Danjovic/AVeRCADE/README.md

# AVeRCADE
Customisable USB adapter for arcade controls.

AVeRCADE is a flexible USB adapter for arcade controls based on AVR and V-USB. It can also work as a generic development board, since it uses USBaspLoader to update the firmware.
