Danjovic/AVeRCADE/Doc/AVerCADE-Digital-connect.png

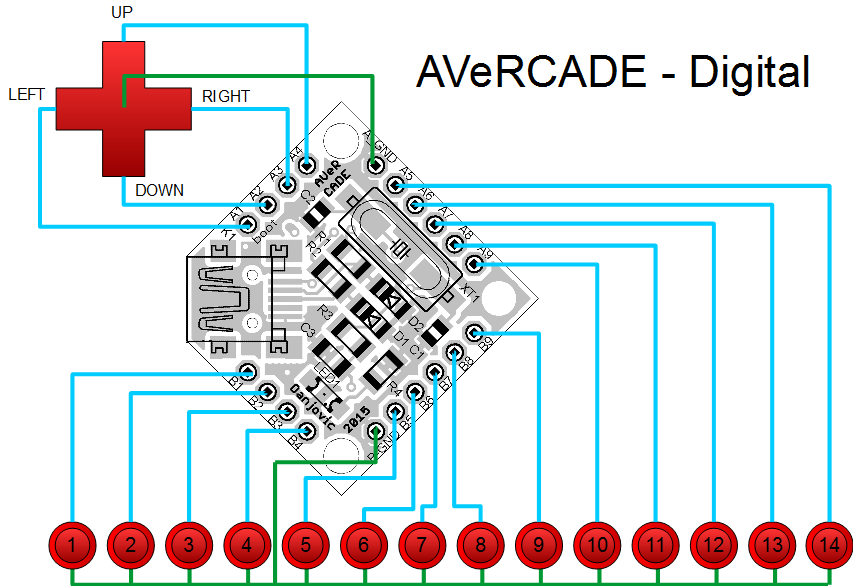
Doc/AVerCADE-Digital-connect.png
