Danjovic/AVeRCADE/Doc/AVerCADE-Dual Analog-connect.png

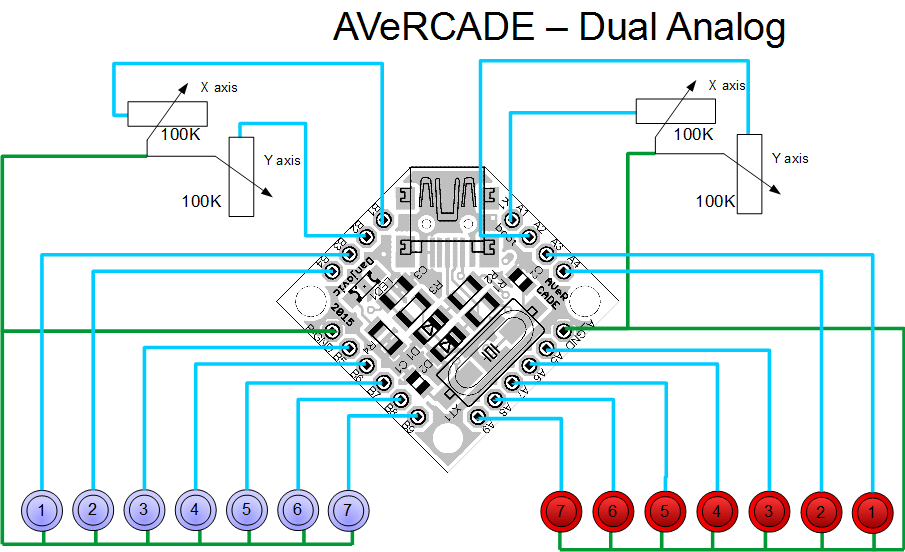
Doc/AVerCADE-Dual Analog-connect.png
