Danjovic/AVeRCADE/Doc/AVerCADE-Dual Digital-connect.png

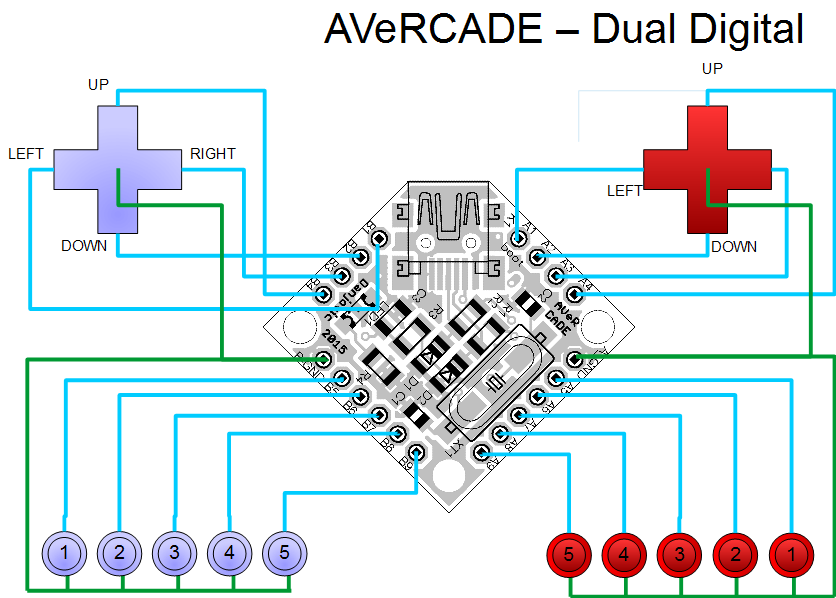
Doc/AVerCADE-Dual Digital-connect.png
