Danjovic/AVeRCADE/Doc/AVeRCADE-Dual Genesis.png

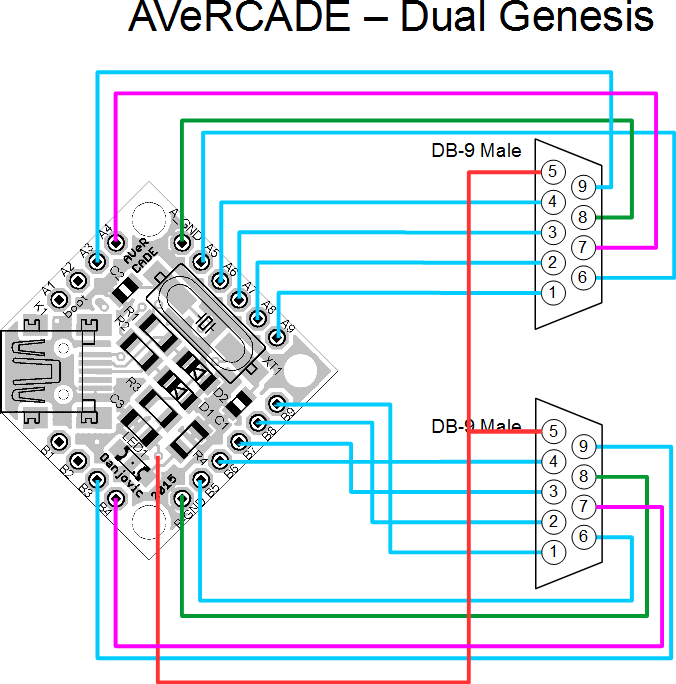
Doc/AVeRCADE-Dual Genesis.png
