Danjovic/AVeRCADE/Doc/AVerCADE-DualAtari-connect.png

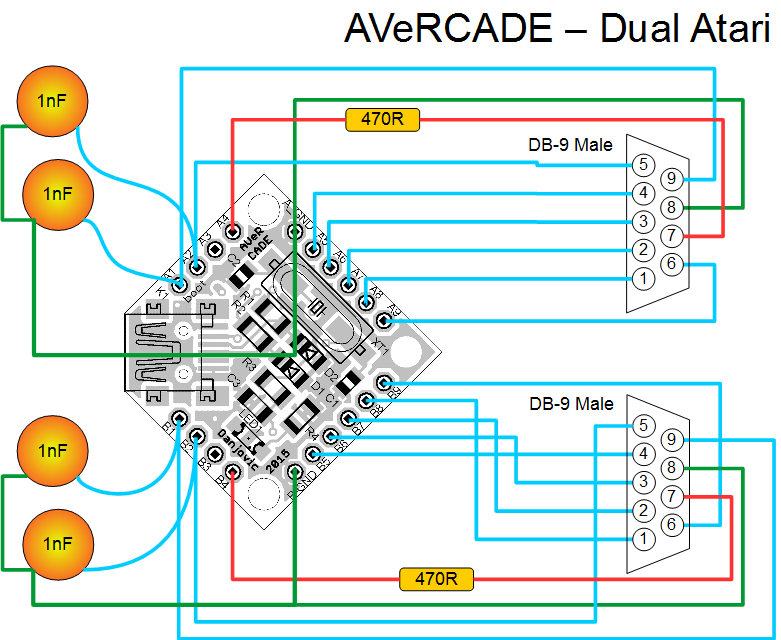
Doc/AVerCADE-DualAtari-connect.png
