Danjovic/AVeRCADE/Doc/AVerCADE-SixAxis-connect.png

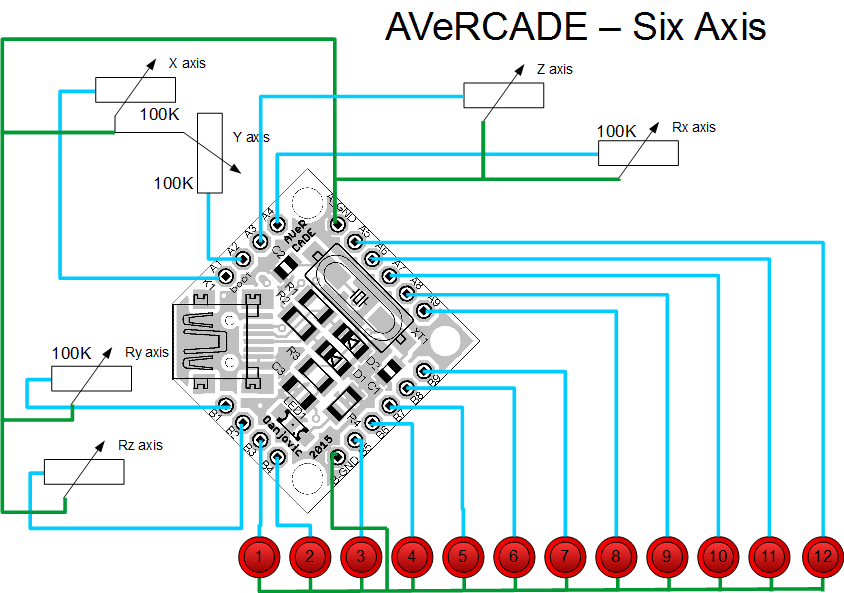
Doc/AVerCADE-SixAxis-connect.png
