Danjovic/AVeRCADE/Doc/AVerCADE-USBasp.png

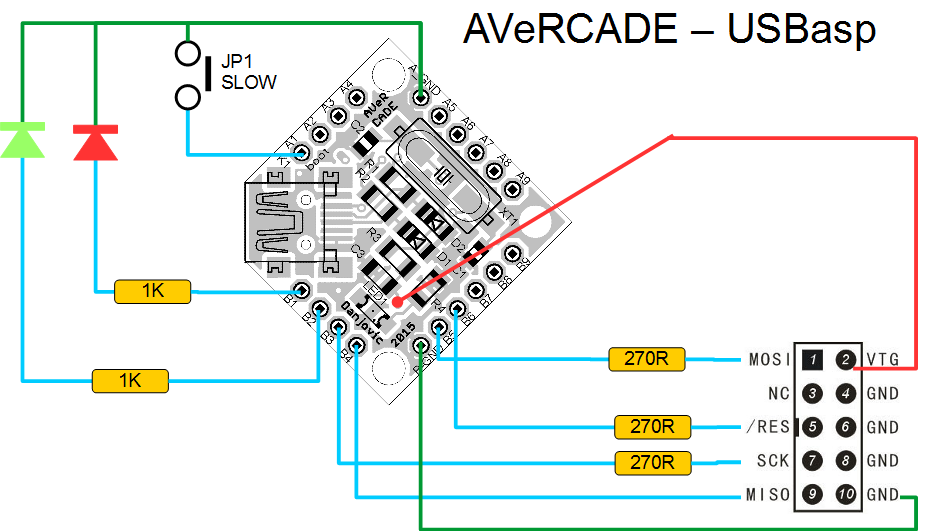
Doc/AVerCADE-USBasp.png
