Danjovic/AVeRCADE/Doc/AVeRCADE-ZX Spectrum Keyboard.png

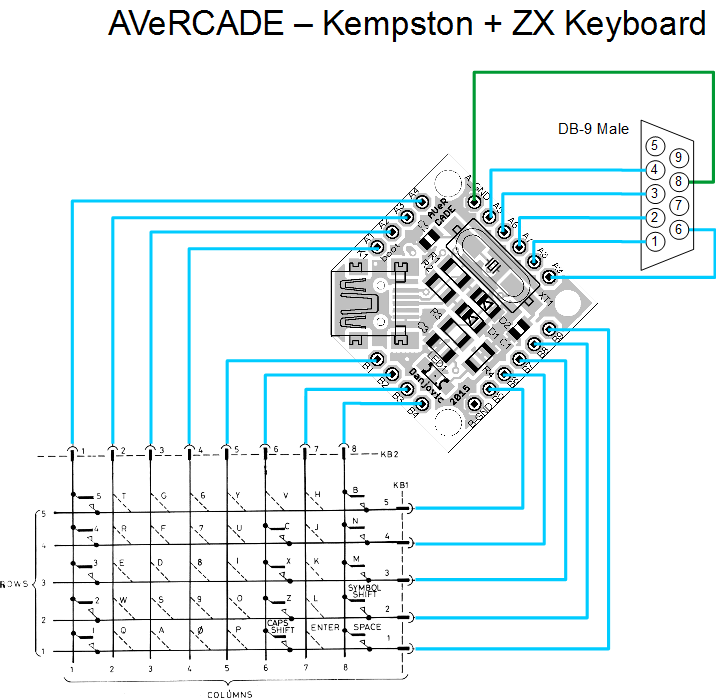
Doc/AVeRCADE-ZX Spectrum Keyboard.png
