Danjovic/AVeRCADE/Doc/burn bootloader ISP10.png

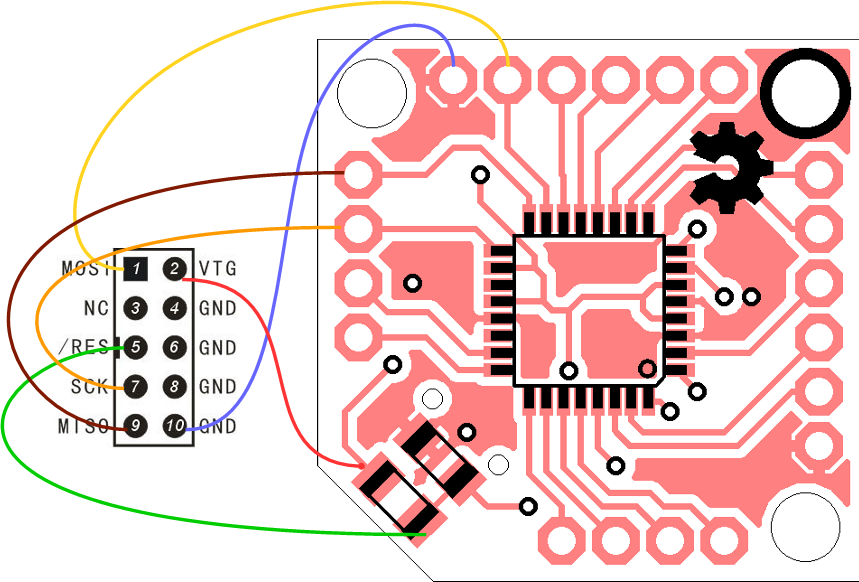
Doc/burn bootloader ISP10.png
