Danjovic/AVeRCADE/Doc/burn bootloader ISP.png

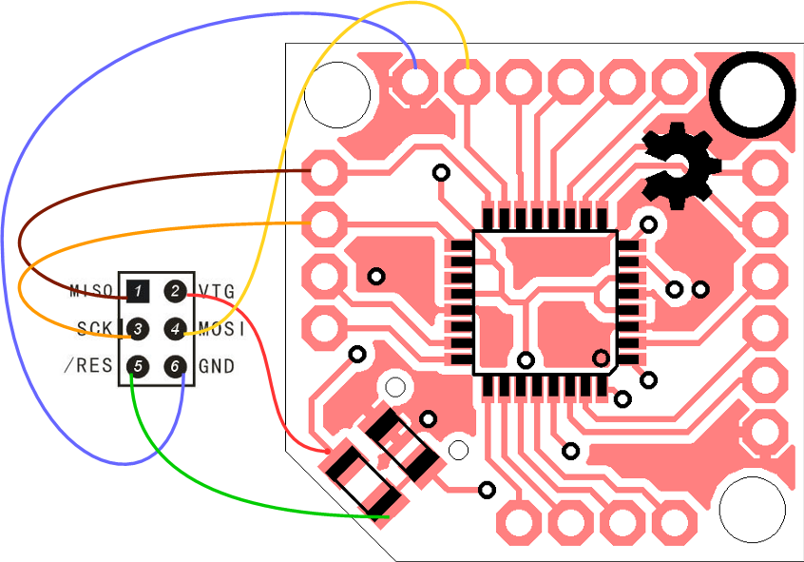
Doc/burn bootloader ISP.png
