Danjovic/AVeRCADE/Doc/Pinout ATMEGA - AVeRCADE - ARDUINO.png

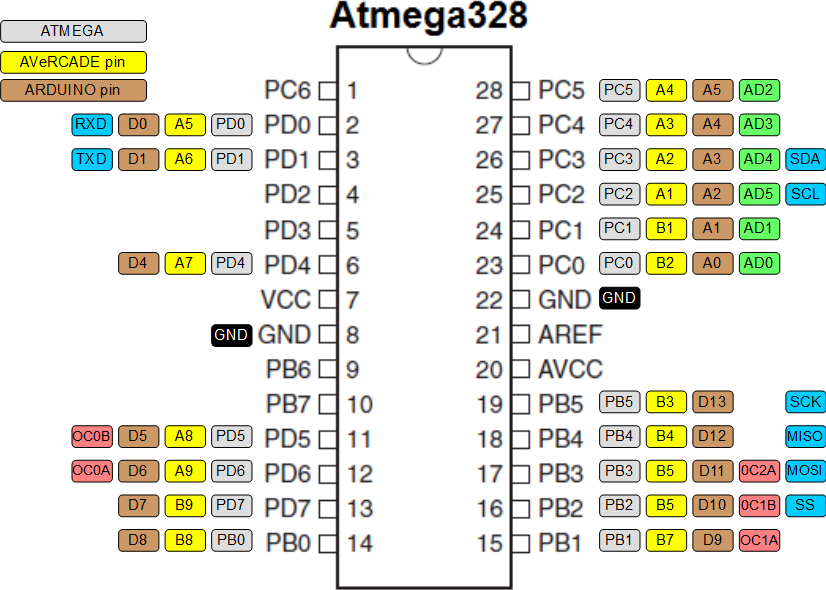
Doc/Pinout ATMEGA - AVeRCADE - ARDUINO.png
