Danjovic/AVeRCADE/Doc/Pinout AVeRCADE - ARDUINO.png

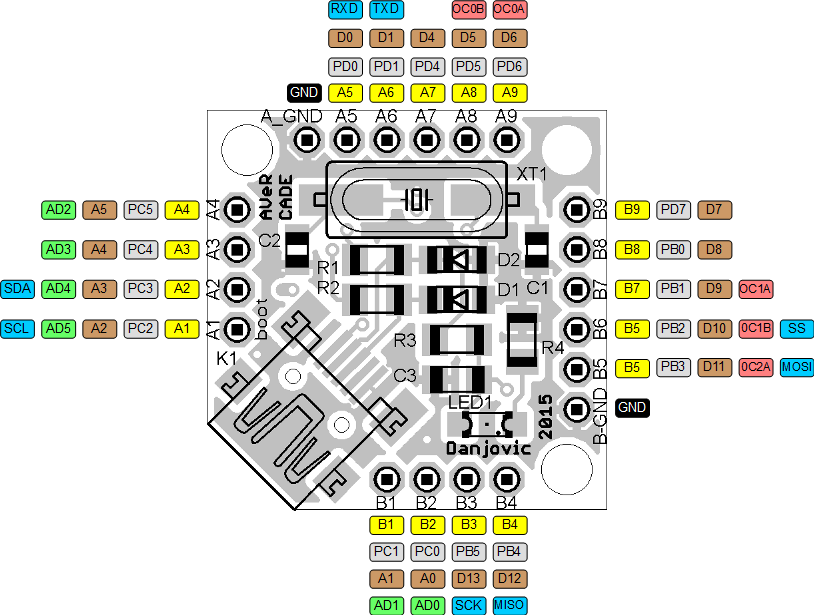
Doc/Pinout AVeRCADE - ARDUINO.png
