Danjovic/AVeRCADE/Circuit/AVerCADE_Dip_SF.brd

## EAGLE design Circuit/AVerCADE_Dip_SF.brd (2020-06-06)

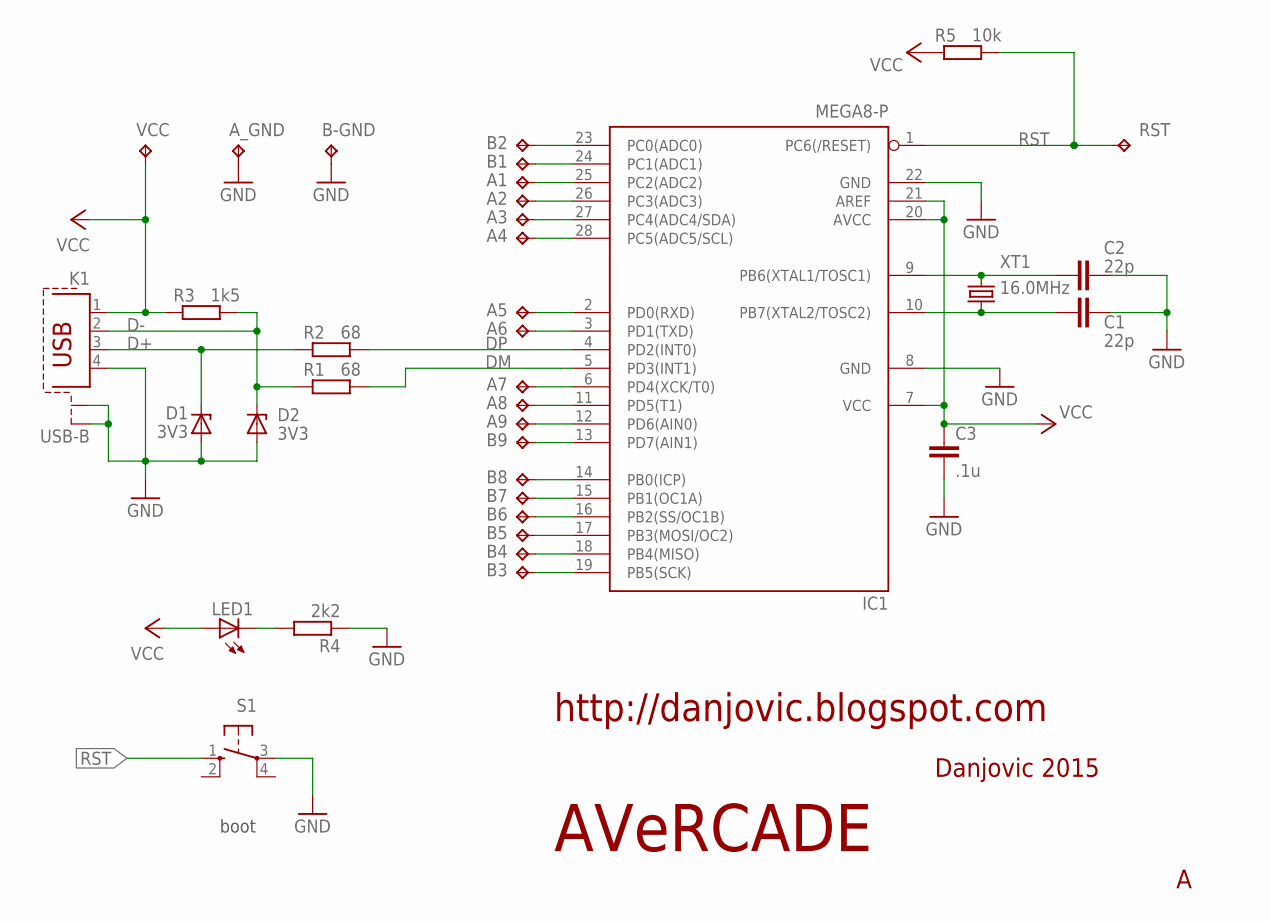
[picture p13: schematic AVerCADE_Dip_SF.sch]

Parts:
A1, A2, A3, A4, A5, A6, A7, A8, A9: TPPAD1-13; P1-13
A_GND: TPPAD1-13; P1-13
B1, B2, B3, B4, B5, B6, B7, B8, B9: TPPAD1-13; P1-13
B-GND: TPPAD1-13; P1-13
C1, C2: 22p; C025-24X044L
C3: .1u; C050-025X075L
D1, D2: 3V3; ZDIO-5L
IC1: MEGA8-P; DIL28-3
K1: USB-B; PN61729-SL
LED1: LEDLED3MML; LED3MML
R1, R2: 68; 0207/7L
R3: 1k5; 0207/7L
R4: 2k2; 0207/7L
R5: 10k; 0207/7L
RST: TPPAD1-13; P1-13
S1: 10-XX; B3F-10XX
VCC: TPPAD1-13; P1-13
XT1: 16.0MHz; HC49U-V

Connections:
AN2: A1.TP, IC1.25 (PC2(ADC2))
AN3: A2.TP, IC1.26 (PC3(ADC3))
D+: D1.C, K1.3, R2.3 (1)
D-: D2.C, K1.2, R1.3 (1), R3.4 (2)
DM: IC1.5 (PD3(INT1)), R1.4 (2)
DP: IC1.4 (PD2(INT0)), R2.4 (2)
GND: A_GND.TP, B-GND.TP, C1.2, C2.2, C3.2, D1.A, D2.A, IC1.8 (GND), IC1.22 (GND), K1.4, K1.S1, K1.S2, R4.3 (1), S1.3
unnamed: A5.TP, IC1.2 (PD0(RXD))
unnamed: A7.TP, IC1.6 (PD4(XCK/T0))
unnamed: B1.TP, IC1.24 (PC1(ADC1))
unnamed: B2.TP, IC1.23 (PC0(ADC0))
unnamed: A3.TP, IC1.27 (PC4(ADC4/SDA))
unnamed: A4.TP, IC1.28 (PC5(ADC5/SCL))
unnamed: A6.TP, IC1.3 (PD1(TXD))
unnamed: A8.TP, IC1.11 (PD5(T1))
unnamed: A9.TP, IC1.12 (PD6(AIN0))
unnamed: B9.TP, IC1.13 (PD7(AIN1))
unnamed: LED1.K (C), R4.4 (2)
unnamed: B8.TP, IC1.14 (PB0(ICP))
unnamed: B6.TP, IC1.16 (PB2(SS/OC1B))
unnamed: B7.TP, IC1.15 (PB1(OC1A))
unnamed: B3.TP, IC1.19 (PB5(SCK))
unnamed: B4.TP, IC1.18 (PB4(MISO))
unnamed: B5.TP, IC1.17 (PB3(MOSI/OC2))
RST: IC1.1 (PC6(/RESET)), R5.4 (2), RST.TP, S1.1 (S)
VCC: C3.1, IC1.7 (VCC), IC1.20 (AVCC), IC1.21 (AREF), K1.1, LED1.A, R3.3 (1), R5.3 (1), VCC.TP
X1: C2.1, IC1.9 (PB6(XTAL1/TOSC1)), XT1.2
X2: C1.1, IC1.10 (PB7(XTAL2/TOSC2)), XT1.1

Notes on the sheet:
boot
Danjovic 2015
AVeRCADE
http://danjovic.blogspot.com

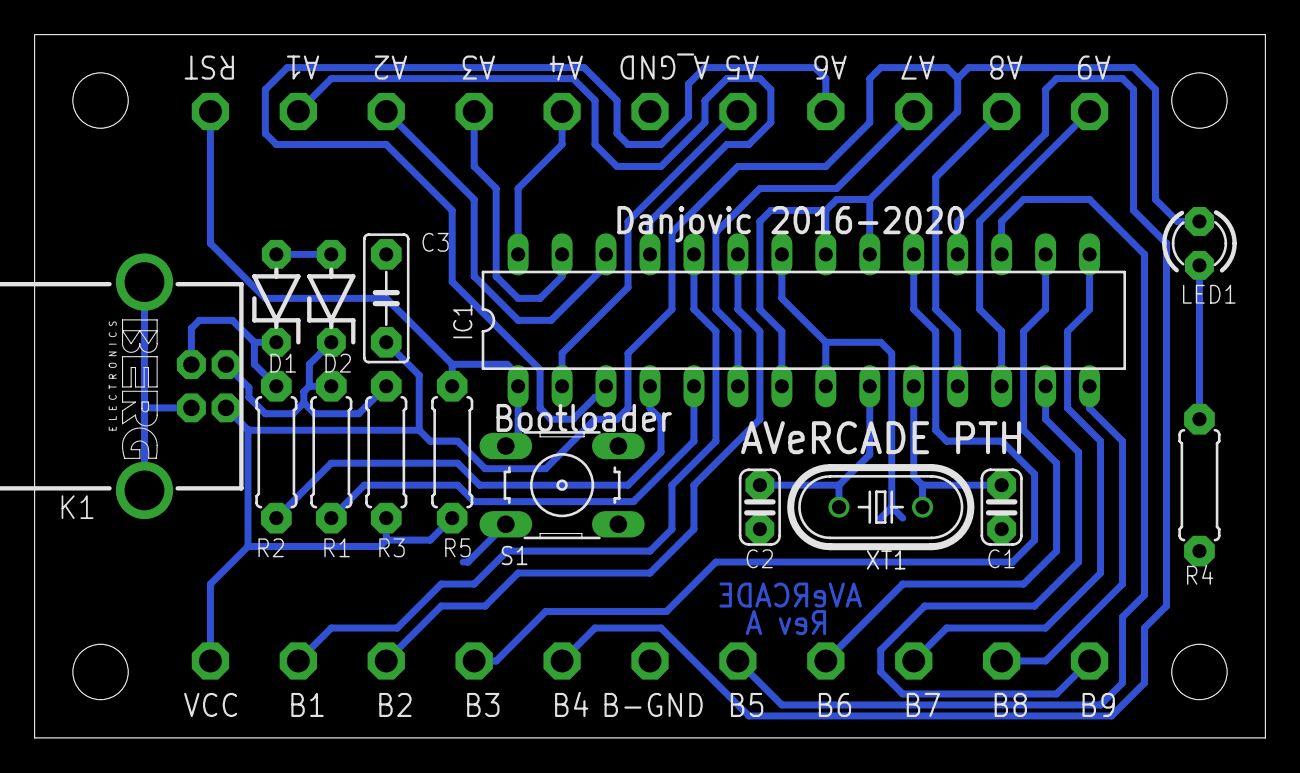
[picture p14: board AVerCADE_Dip_SF.brd from above]

Board: 2 copper layers, 71.1 x 40.6 mm, 37 parts (0 on the bottom side), 28 nets.
