Danjovic/AVeRCADE/Circuit/AVerCADE.brd

## EAGLE design Circuit/AVerCADE.brd (2015-11-21)

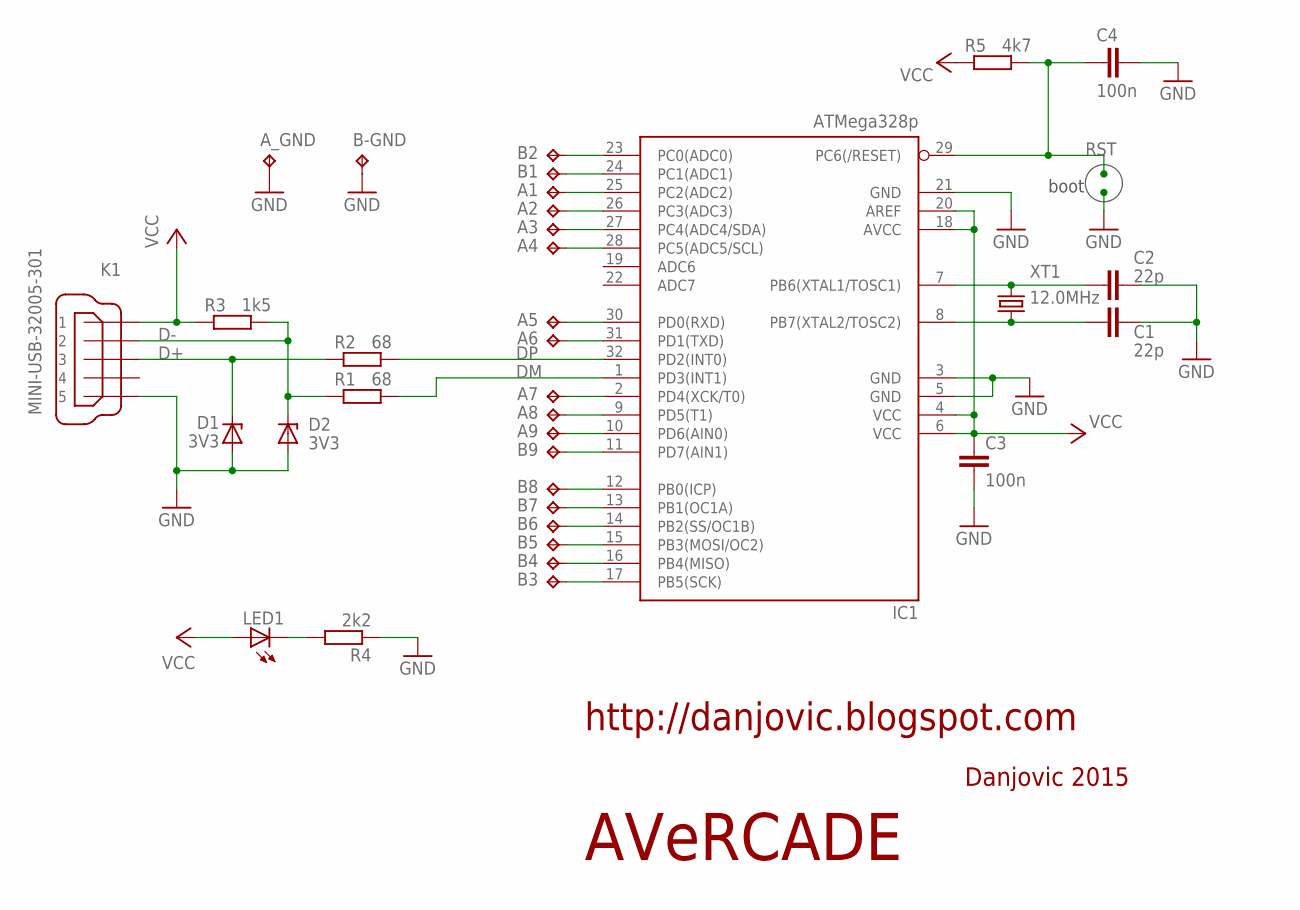
[picture p15: schematic AVerCADE.sch]

Parts:
A1, A2, A3, A4, A5, A6, A7, A8, A9: TPPAD1-13; P1-13
A_GND: TPPAD1-13; P1-13
B1, B2, B3, B4, B5, B6, B7, B8, B9: TPPAD1-13; P1-13
B-GND: TPPAD1-13; P1-13
C1, C2: 22p; C0805
C3, C4: 100n; C1206
D1, D2: 3V3; SOD80C
IC1: ATMega328p; TQFP32-08
K1: MINI-USB-32005-301; 32005-301
LED1: LEDSML1206; SML1206
R1, R2: 68; M1206
R3: 1k5; M1206
R4: 2k2; M1206
R5: 4k7; M1206
XT1: 12.0MHz; HC49UP

Connections:
AN2: A1.TP, IC1.25 (PC2(ADC2))
AN3: A2.TP, IC1.26 (PC3(ADC3))
D+: D1.C, K1.3, R2.1
D-: D2.C, K1.2, R1.1, R3.2
DM: IC1.1 (PD3(INT1)), R1.2
DP: IC1.32 (PD2(INT0)), R2.2
GND: A_GND.TP, B-GND.TP, C1.2, C2.2, C3.2, C4.2, D1.A, D2.A, IC1.3 (GND), IC1.5 (GND), IC1.21 (GND), K1.5, R4.1
unnamed: A5.TP, IC1.30 (PD0(RXD))
unnamed: A7.TP, IC1.2 (PD4(XCK/T0))
unnamed: B1.TP, IC1.24 (PC1(ADC1))
unnamed: B2.TP, IC1.23 (PC0(ADC0))
unnamed: A3.TP, IC1.27 (PC4(ADC4/SDA))
unnamed: A4.TP, IC1.28 (PC5(ADC5/SCL))
unnamed: A6.TP, IC1.31 (PD1(TXD))
unnamed: A8.TP, IC1.9 (PD5(T1))
unnamed: A9.TP, IC1.10 (PD6(AIN0))
unnamed: B9.TP, IC1.11 (PD7(AIN1))
unnamed: LED1.C, R4.2
unnamed: B8.TP, IC1.12 (PB0(ICP))
unnamed: B6.TP, IC1.14 (PB2(SS/OC1B))
unnamed: B7.TP, IC1.13 (PB1(OC1A))
unnamed: B3.TP, IC1.17 (PB5(SCK))
unnamed: B4.TP, IC1.16 (PB4(MISO))
unnamed: B5.TP, IC1.15 (PB3(MOSI/OC2))
RST: C4.1, IC1.29 (PC6(/RESET)), R5.2
VCC: C3.1, IC1.4 (VCC), IC1.6 (VCC), IC1.18 (AVCC), IC1.20 (AREF), K1.1, LED1.A, R3.1, R5.1
X1: C2.1, IC1.7 (PB6(XTAL1/TOSC1)), XT1.2
X2: C1.1, IC1.8 (PB7(XTAL2/TOSC2)), XT1.1

Notes on the sheet:
boot
Danjovic 2015
AVeRCADE
http://danjovic.blogspot.com

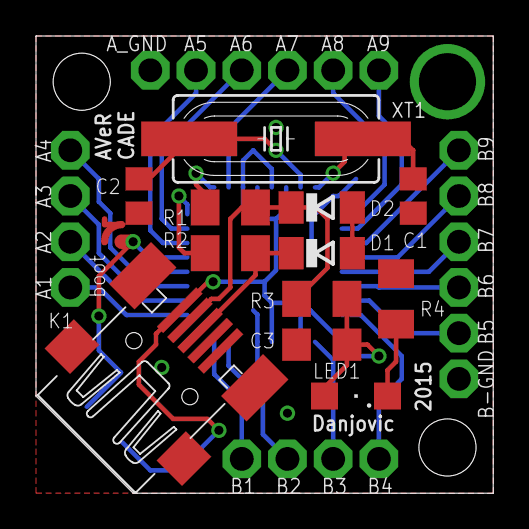
[picture p16: board AVerCADE.brd from above]

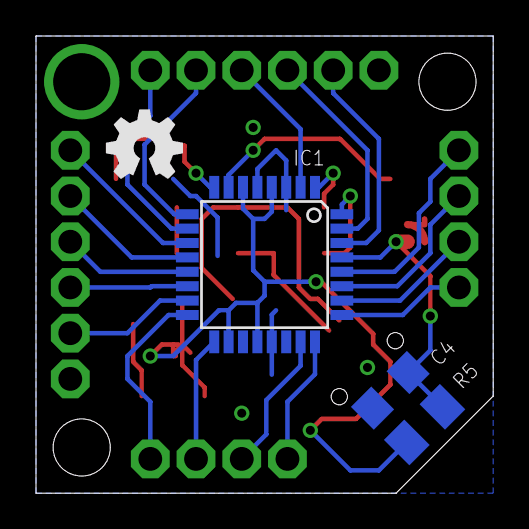
[picture p17: board AVerCADE.brd from below]

Board: 2 copper layers, 25.4 x 25.4 mm, 35 parts (3 on the bottom side), 28 nets.
