Danjovic/AVeRCADE/(commit log)

2015-11-21 Creation of repository
    Repository created at current stage of development
    [AVerCADE.brd, AVerCADE.sch]
2015-11-27 Added fuse configuration for ATMEGA8
2015-12-04 Corrected Makefiles for ATMEGA8 @ 16MHz
    [main.c, usbconfig.h]
2016-07-22 Added firmware for dual Sega Genesis, 6 button
2016-07-26 Added singlesided board w/ through hole components
    [AVerCADE_Dip_SF.brd, AVerCADE_Dip_SF.sch]
2016-07-28 Enhanced PTH board for homemade built.
    The component pads have been enlarged to ease the home built versions of the board.
    [AVerCADE_Dip_SF.brd, AVerCADE_Dip_SF.sch]
2017-03-25 Debouncing added to Digital firmware
    Added timed sample of buttons (16ms) as a countermeasure for contact bouncing.
2020-06-06 Added bootloader invoke button, increased clearance on LED pads
    [AVerCADE_Dip_SF.brd, AVerCADE_Dip_SF.sch]
